Bizintek/mOway_Hardware/README.md

# mOway_Hardware
Project IR: PCB of the 4 obstacle sensors.

Project Moway: Main PCB of the mOway robot.
## License
This project is licensed under the Attribution-ShareAlike 4.0 International - see the LICENSE.md file for details
