Bizintek/mOway_Hardware/IR/Assembly/BOM/Bizintek - Bill of Materials-MIN_MOW_03 IR_V3.xlsx

 |  |  |  |  |  |  |  |  |  | Project | MIN_MOW_03 IR_V3.PrjPcb
 |  |  |  |  |  |  |  |  |  | Revision | V2
 |  |  |  |  |  |  |  |  |  | Date | 10/04/2018 11:36:07
 |  |  |  |  |  |  |  |  |  | Author | AVI
PCB COMPONENTS
Designator | Description | Comment | Value | Footprint | Manufacturer | Manufacturer Part Number | Quantity | Supplier 1 | Supplier Part Number 1 | Supplier 2 | Supplier Part Number 2
C1, C2, C3, C4 | CAPACITOR SMD 0603, 22nF , 10V, X7R | C22NV10X7R0603 | 22nF | C0603 |  |  | 4
C5 | CAPACITOR SMD 0603, 100nF, 10V, X7R | C100NV10X7R0603 | 100nF | C0603 |  |  | 1
EXT1 | PCB_MINMOW_V3_IR | PCB_MINMOW_V3_IR |  |  | BIZINTEK | PCB_MINMOW_V2_IR | 1
Q1, Q2, Q3, Q4 | SMT Phototransistor, 15º angle, 910nm, 3.45mA (SIDE MOUNTING) | PT100MF0MP | 35V/0.02A | PT100MF0MP_SIDE | SHARP | PT100MF0MP | 4 | Mouser | 852-PT100MF0MP | Digikey | 425-1006-1-ND
R1, R2, R11, R12 | RESISTOR SMD 0402, 39kOhm, 1% | R39KT10402 | 39kOhm | R0402 |  |  | 4
R3, R4, R5, R6, R15, R16, R17, R18 | RESISTOR SMD 0402, 4.7kOhm, 1% | R4K7T10402 | 4.7kOhm | R0402 |  |  | 8
R7, R9, R19, R21 | RESISTOR SMD 0402, 22kOhm, 1% | R22KT10402 | 22kOhm | R0402 |  |  | 4
R8, R10, R20, R22 | RESISTOR SMD 0402, 1kOhm, 1% | R1KT10402 | 1kOhm | R0402 |  |  | 4
R13, R14, R23, R24 | RESISTOR SMD 0402, 100Ohm, 1% | R100T10402 | 100Ohm | R0402 |  |  | 4
U1 | 1MHz Low-Power Op Amp | MCP6004IST |  | TSSOP14_MCP | MICROCHIP | MCP6004-I/ST | 1 | Digikey | MCP6004-I/ST-ND | Mouser | 579-MCP6004-I/ST
