Bizintek/mOway_Hardware/Moway/Assembly/BOM/Bizintek - Bill of Materials-MIN_MOW_03_V3.xlsx

 |  |  |  |  |  |  |  |  |  | Project | MIN_MOW_03_V3.PrjPcb
 |  |  |  |  |  |  |  |  |  | Revision | V2
 |  |  |  |  |  |  |  |  |  | Date | 10/04/2018 11:30:09
 |  |  |  |  |  |  |  |  |  | Author | AVI
PCB COMPONENTS
Designator | Description | Comment | Value | Footprint | Manufacturer | Manufacturer Part Number | Quantity | Supplier 1 | Supplier Part Number 1 | Supplier 2 | Supplier Part Number 2
C1, C2, C3, C4, C10, C15, C17, C22, C29 | CAPACITOR SMD 0402, 100nF, 10V, X7R | C100NV10X7R0402 | 100nF | C0402 |  |  | 9
C5, C14, C20, C27, C28 | CAPACITOR SMD 0603, 10uF, 10V, X5R | C10UV10X5R0603 | 10uF | C0603 |  |  | 5
C6, C7 | CAPACITOR SMD 0402, 18pF, 10V, C0G | C18PV10C0G0402 | 18pF | C0402 |  |  | 2
C8, C12, C16, C19, C21, C30, C31 | CAPACITOR SMD 0402, 1uF, 10V, X5R | C1UV10X5R0402 | 1uF | C0402 |  |  | 7
C9, C18, C25, C26 | CAPACITOR SMD 0402, 4.7uF, 10V, X5R | C4U7V10X5R0402 | 4.7uF | C0402 |  |  | 4
C11, C13 | CAPACITOR SMD 0603, 33pF, 10V, C0G | C33PV10C0G0603 | 33pF | C0603 |  |  | 2
C23, C24 | CAPACITOR SMD 0402, 1nF, 10V, X7R | C1NV10X7R0402 | 1nF | C0402 |  |  | 2
D1, D2 | IR-LED, SMD, 3mm x 2mm x 1 mm, 1,2V, 20mA, 940nm | KPA3010F3C |  | KPA3010 | KINGBRIGHT | KPA-3010F3C | 2 | Farnell | 2426200 | RS | 862-4705
D3 | IR-LED, SMD, 3mm x 2mm x 1 mm, 1,2V, 20mA, 940nm | DNP |  | KPA3010F3C_MOWAY | KINGBRIGHT | KPA-3010F3C | 1 | Farnell | 2426200 | RS | 862-4705
D4 | LED, Low Power, Green, SMD, 1.6mm x 2mm, 20mA, 2.2V, 568nm | KPC3216SGC |  | LED1206G | KINGBRIGHT | KPC-3216SGC | 1 | Farnell | 1318254 | RS | 466-3908
D5 | LED, Low Power, Red, SMD, 20 mA, 1.9 V, 628 nm | KP3216SURC |  | LED1206 | KINGBRIGHT | KP-3216SURC | 1 | Farnell | 8530017 | RS | 466-3920
D6 | LED Osram Opto, White, 4.5 lm, 5600K, 3.2 V, 120°, SIDELED serie | LWA6SGV2BAJKPL |  | LWA6SG | OSRAM | LW A6SG-V2BA-JKPL | 1 | Mouser | 720-LWA6SGV2BAJKPLZI | RS | 688-9578
D7, D8 | LED, Right Angle, Red, SMD, 20mA, 2V, 617nm | KPA3010EC |  | KPA3010 | KINGBRIGHT | KPA-3010EC | 2 | Farnell | 8530327 | RS | 862-4695
D9 | LED, Low Power, Red, SMD, 20 mA, 1.95 V, 630 nm | KPHCM2012SURCK |  | LED0805 | KINGBRIGHT | KPHCM-2012SURCK | 1 | Farnell | 1686067 | RS | 861-0119
D10 | LED, Low Power, Green, SMD, 20 mA, 2.1 V, 570 nm | KPHCM2012CGCK |  | LED0805 | KINGBRIGHT | KPHCM-2012CGCK | 1 | Farnell | 1686075 | RS | 861-0107
D11 | TVS Diode, SD05T1 Series, Unidirectional, 5 V, 14.5 V, SOD-323, 2 Pins | SD05T1G | 5V | SOD323_ONSEMI | ON SEMICONDUCTOR | SD05T1G | 1 | Farnell | 2463641 | Mouser | 863-SD05T1G
EXT1 | PCB_MINMOW_V3_MOWAY | PCB_MINMOW_V3_MOWAY |  |  | BIZINTEK |  | 1
EXT2, EXT4 | LIGHT PIPE | 5151049F |  | 5151049F | DIALIGHT | 5151049F | 2 | Digikey | 350-2175-ND | Mouser | 645-515-1049F
EXT3 | Light Pipe | PIPE44 |  | PIPE44_MR | MINIROBOTS | PIPE44 | 1
EXT5 | Li-Polymer Battery, 3.7V, 300mAh | LP602030 | 3.7V/0.30Ah |  | EEMB | LP602030 | 1
F1 | PPTC Resettable Fuse, SMD, MF-NSMF Series, 750 mA, 1.5 A, 6 V, -40 °C | MFNSMF0752 | 0.75A | F1206 | BOURNS | MF-NSMF075-2 | 1 | Digikey | MF-NSMF075-2CT-ND | Mouser | 652-MF-NSMF075-2
J1 | Ambient Light Photosensor, APDS-9005, Miniature, SMD, chipLED, Analogue, 1.8 V to 5.5 V | APDS9005020 |  | APDS9005020 | AVAGO | APDS-9005-020 | 1 | Mouser | 630-APDS-9005-020 | Digikey | 516-1717-1-ND
J3 | Board to Board connector, SMD, 6 pin, 1.27 pitch | 2215203G00DN3U |  | 22152X03_OUPIIN | OUPIIN | 2215-2X03G00DN-3U | 1 | MATRIX | 2215-2*03G00DN/3U
J4 | Expansion Connector, 8 pin, SMD Female | 20431X08TDATR |  | 20431X08TDATR_OUPIIN | OUPIIN | 2043-1X-08-T-D-A-TR | 1 | MATRIX | 2043-1X-08-T-D-A-TR
J6, J7, J8 | Wire-To-Board Connector, Top Entry, 1 mm, 2 Contacts, Header, SR Series, Surface Mount, 1 Rows | BM02BSRSSTB |  | BM02BSRSSTB_JST | JST | BM02B-SRSS-TB | 3 | Digikey | 455-1788-1-ND | Farnell | 1679127
L1, L2 | INDUCTOR SMD 120 Ohm / 100MHz, 2A, 0603 | BLM18PG121SN1D | 120 Ohm / 100MHz | L0603 | MURATA | BLM18PG121SN1D | 2 | Digikey | 490-1037-1-ND | Mouser | 81-BLM18PG121SN1D
MK1 | Electret Condenser Microphone | CMC5042PFAC |  | CMC5042PFAC | CUI | CMC-5042PF-AC | 1 | Digikey | 102-1724-ND | Mouser | 490-CMC-5042PF-AC
Q1, Q3, Q4, Q5, Q6, Q7, Q8, Q9, Q10, Q11, Q12, Q13, Q14 | Bipolar (BJT) Single Transistor, NPN, 45 V, 170 MHz, 300 mW, 500 mA, 250 hFE | BC81740MTF | 45V/0.5A | SOT23_FAIRCHILD | FAIRCHILD | BC81740MTF | 13 | Farnell | 1798081 | Mouser | 512-BC81740MTF
Q2 | Bipolar (BJT) Single Transistor, NPN, 45 V, 170 MHz, 300 mW, 500 mA, 250 hFE | DNP | 45V/0.5A | SOT23_FAIRCHILD | FAIRCHILD | BC81740MTF | 1 | Farnell | 1798081 | Mouser | 512-BC81740MTF
R1, R13, R14 | RESISTOR SMD 0402, 10Ohm, 1% | R10T10402 | 10Ohm | R0402 |  |  | 3
R2 | RESISTOR SMD 0402, 33kOhm, 1% | R33KT10402 | 33kOhm | R0402 |  |  | 1
R3, R21, R38, R50, R53 | RESISTOR SMD 0402, 560Ohm, 1% | R560T10402 | 560Ohm | R0402 |  |  | 5
R4 | RESISTOR SMD 0402, 10Ohm, 1% | DNP | 10Ohm | R0402 |  |  | 1
R5 | Thermistor, NTC, 10 kohm, NB12 Series, 3630 K, SMD, 0805 | NB12K00103KBB | 10kOhm | R0805 | AVX | NB12K00103KBB | 1 | Farnell | 1672287 | Mouser | 581-NB12K00103KBB
R6 | RESISTOR SMD 0402, 100Ohm, 1% | DNP | 100Ohm | R0402 |  |  | 1
R7, R46, R48, R49, R51, R77, R78, R79, R81, R83, R84 | RESISTOR SMD 0402, 10kOhm, 1% | R10KT10402 | 10kOhm | R0402 |  |  | 11
R8, R47, R52 | RESISTOR SMD 0402, 15kOhm, 1% | R15KT10402 | 15kOhm | R0402 |  |  | 3
R9, R15, R20, R86 | RESISTOR SMD 0402, 100Ohm, 1% | R100T10402 | 100Ohm | R0402 |  |  | 4
R10, R11, R12, R16, R17, R18, R24, R25, R28, R29, R30, R32, R33 | RESISTOR SMD 0402, 180Ohm, 1% | R180T10402 | 180Ohm | R0402 |  |  | 13
R19, R31, R75 | RESISTOR SMD 0402, 150Ohm, 1% | R150T10402 | 150Ohm | R0402 |  |  | 3
R22, R23, R42, R43, R45 | RESISTOR SMD 0402, 4.7kOhm, 1% | R4K7T10402 | 4.7kOhm | R0402 |  |  | 5
R26, R34 | RESISTOR SMD 0402, 12kOhm, 1% | R12KT10402 | 12kOhm | R0402 |  |  | 2
R27, R35, R41, R54, R55, R56, R57, R58, R59, R60, R61, R66, R67, R68, R69, R70, R71, R72, R73, R80, R82 | RESISTOR SMD 0402, 1kOhm, 1% | R1KT10402 | 1kOhm | R0402 |  |  | 21
R36, R37, R44, R85 | RESISTOR SMD 0402, 100kOhm, 1% | R100KT10402 | 100kOhm | R0402 |  |  | 4
R39 | RESISTOR SMD 0402, 220kOhm, 1% | R220KT10402 | 220kOhm | R0402 |  |  | 1
R40 | Varistor SMD | CG0603MLC05LE |  | V0603 | BOURNS | CG0603MLC-05LE | 1 | Digikey | CG0603MLC-05LECT-ND | Mouser | 652-CG0603MLC-05RE
R62, R63, R64, R65 | RESISTOR SMD 0402, 1MOhm, 1% | R1MT10402 | 1MOhm | R0402 |  |  | 4
R74 | RESISTOR SMD 0402, 3.3kOhm, 1% | R3K3T10402 | 3.3kOhm | R0402 |  |  | 1
R76 | RESISTOR SMD 0402, 470Ohm, 1% | R470T10402 | 470Ohm | R0402 |  |  | 1
SW1 | Slide Switch, DPDT, On-On, SMD, 300 mA | MMS228T |  | MMS228T | KNITTER | MMS 228-T | 1 | Farnell | 8546819 | RS | 711-8329
U1 | 80-pin 1-Mbit FLASH USB MCU | PIC18F87J50TIPT |  | TQFP80_MCP | MICROCHIP | PIC18F87J50T-I/PT | 1 | Digikey | PIC18F87J50-I/PT-ND | Mouser | 579-PIC18F87J50-I/PT
U2, U3 |  | CNY70 |  |  |  |  | 2
U5 | PIEZO BUZZER TRANSDUCER, 73dB a 5V 10cm | CMT1102SMT |  | CMT1102SMT | CUI | CMT-1102-SMT | 1 | Digikey | 102-1264-1-ND | Mouser | 490-CMT-1102-SMT-TR
U6 | 1MHz Low-Power Op Amp | MCP6001RTEOT |  | SOT23-5_MCP | MICROCHIP | MCP6001RT-E/OT | 1 | Digikey | MCP6001RT-E/OTCT-ND | Mouser | 579-MCP6001RT-E/OT
U7 | MEMS Accelerometer, 3-Axis, Digital, X, Y, Z, ± 2g, ± 4g, ± 8g, 1.95 V, 3.6 V, QFN | MMA8452Q |  | QFN16-5x3_NXP | NXP | MMA8452Q | 1 | Mouser | 841-MMA8452Q | Farnell | 1842360
U8 | USB Connector, Mini USB Type B, 5 Ways, SMD | 8969B05C00DBT |  | 8969B05C00DBT_OUPIIN | OUPIIN | 8969-B05C00DBT | 1 | MATRIX | 8969-B05C00DBT
U9 | TVS Diode, RailClamp Series, 5 V, 18 V, SOT-666, 6 Pins | RCLAMP0502A | 5V | SOT666_SEMTECH | SEMTECH | RCLAMP0502A | 1 | Digikey | RCLAMP0502ACT-ND | Mouser | 947-RCLAMP0502A.TCT
U10, U12 | High Sensitivity Photointerrupter | KRC011 |  | KRC011 | KINGBRIGHT | KRC011 | 2 | RS | 616-5709
U11 | 20 PIN FLASH 8-Bit CMOS MCU | PIC16F687TISS |  | SSOP20_MCP | MICROCHIP | PIC16F687T-I/SS | 1 | Digikey | PIC16F687T-I/SSCT-ND | Mouser | 579-PIC16F687T-I/SS
U13, U14, U15, U16, U19 | Dual MOSFET, N and P Channel, 460 mA, 25 V, 0.33 ohm, 4.5 V, 800 mV | FDC6321CD84Z | N:25V/0.68A; P:25V/0.46A | SUPERSOT6_ONSEMI | FAIRCHILD | FDC6321C D84Z | 5 | Farnell | 9844848 | Mouser | 512-FDC6321C
U17 | Battery Charger for 1 Cell of Li-Ion, Li-Pol battery, 6V input, 4.2V / 500mA charge | MCP73831T2DCIOT | 4.2V/0.5A | SOT23-5_MCP | MICROCHIP | MCP73831T-2DCI/OT | 1 | Digikey | MCP73831T-2DCI/OTCT-ND | Mouser | 579-MCP73831T-2DCIOT
U18 | 500mA Fixed Output CMOS LDO. 6V Vin, 3.3 Vout, 0.5Aout | TC126233VDB | 3.3V/0.5A | SOT223_MCP | MICROCHIP | TC1262-3.3VDB | 1 | Digikey | TC1262-3.3VDB-ND | Mouser | 579-TC1262-3.3VDB
Y11 | Crystal, 12MHz, SMD, 5mm x 3.2mm, 8pF, 50ppm | NX5032GA12MHZLNCD1 | 12MHz | NX5032GA_NDK | NDK | NX5032GA-12.000000MHZ-LN-CD-1 | 1 | Digikey | 644-1034-1-ND
