Bizintek/mOway_Hardware/IR/ExportSTEP/MIN_MOW_03 IR_V3 PCB.step

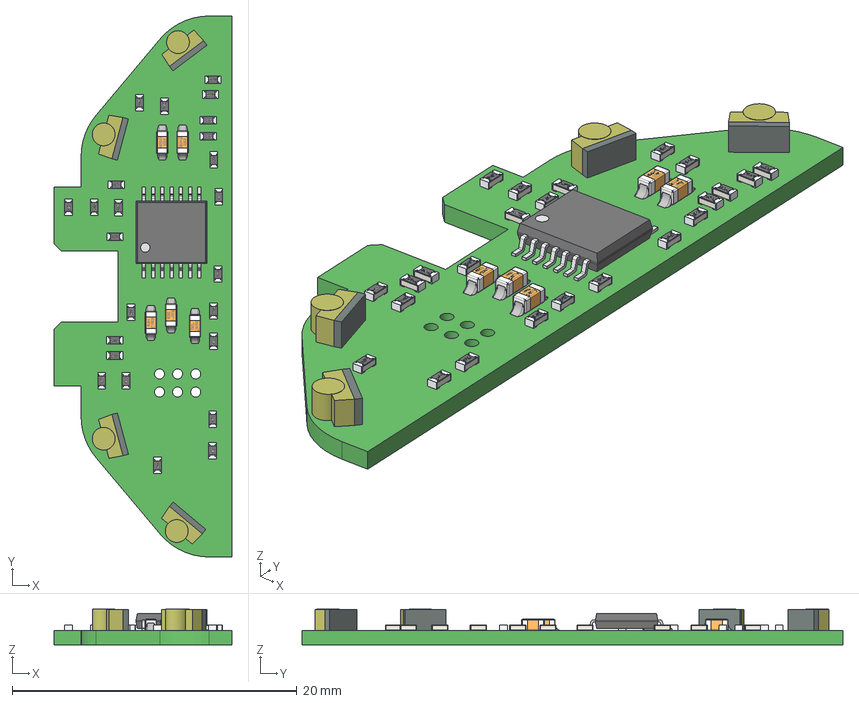
[picture p4: CAD file, 2018-06-08]
IR/ExportSTEP/MIN_MOW_03 IR_V3 PCB.step
12.5 x 38.0 x 2.51 mm
Board
User_Library-0603_Cap x 5
Extruded x 8
User_Library-RES_1005-0402 x 24
User_Library-TSSOP-14__X2_041A043E0440043F04430441_X0_
User_Library-TSSOP-14__X2_041C04350442043A0430_X0_
User_Library-TSSOP-14__X2_041D043E0436043A0430_X0_ x 7
