Bizintek/mOway_Hardware/IR/Design (CONF)/Schematic Prints.PDF

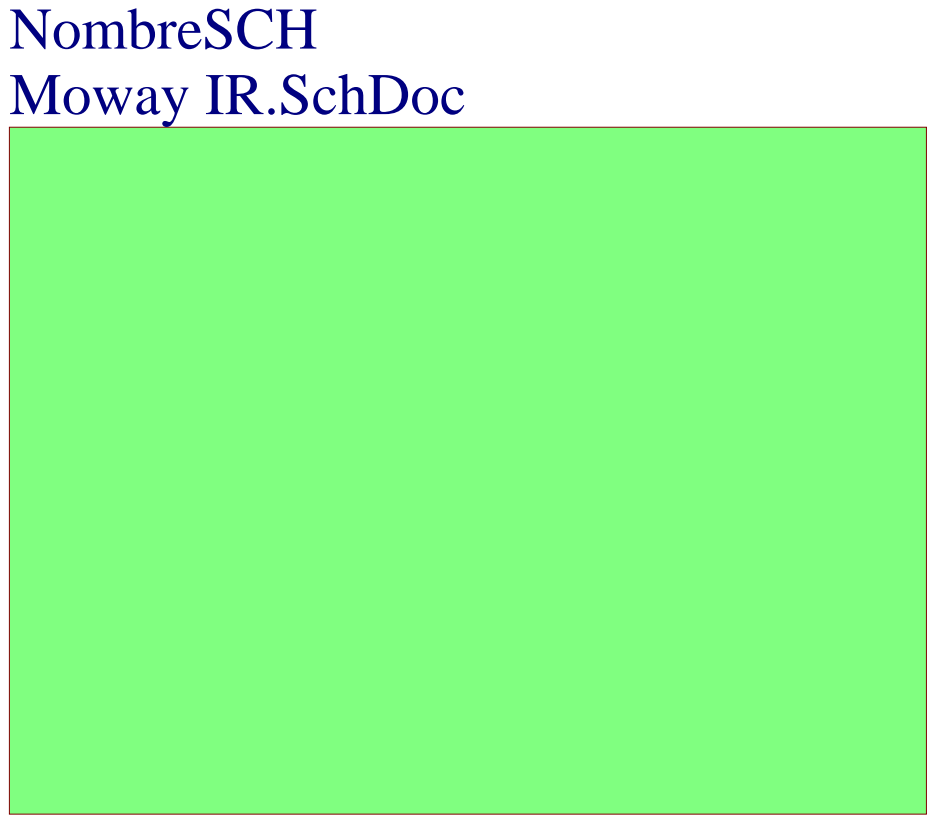
[picture p11: page 1]

Revision: V2 | 10/04/2018 | Sheet: 1 of 2
Author: AVI | Library Version: 2

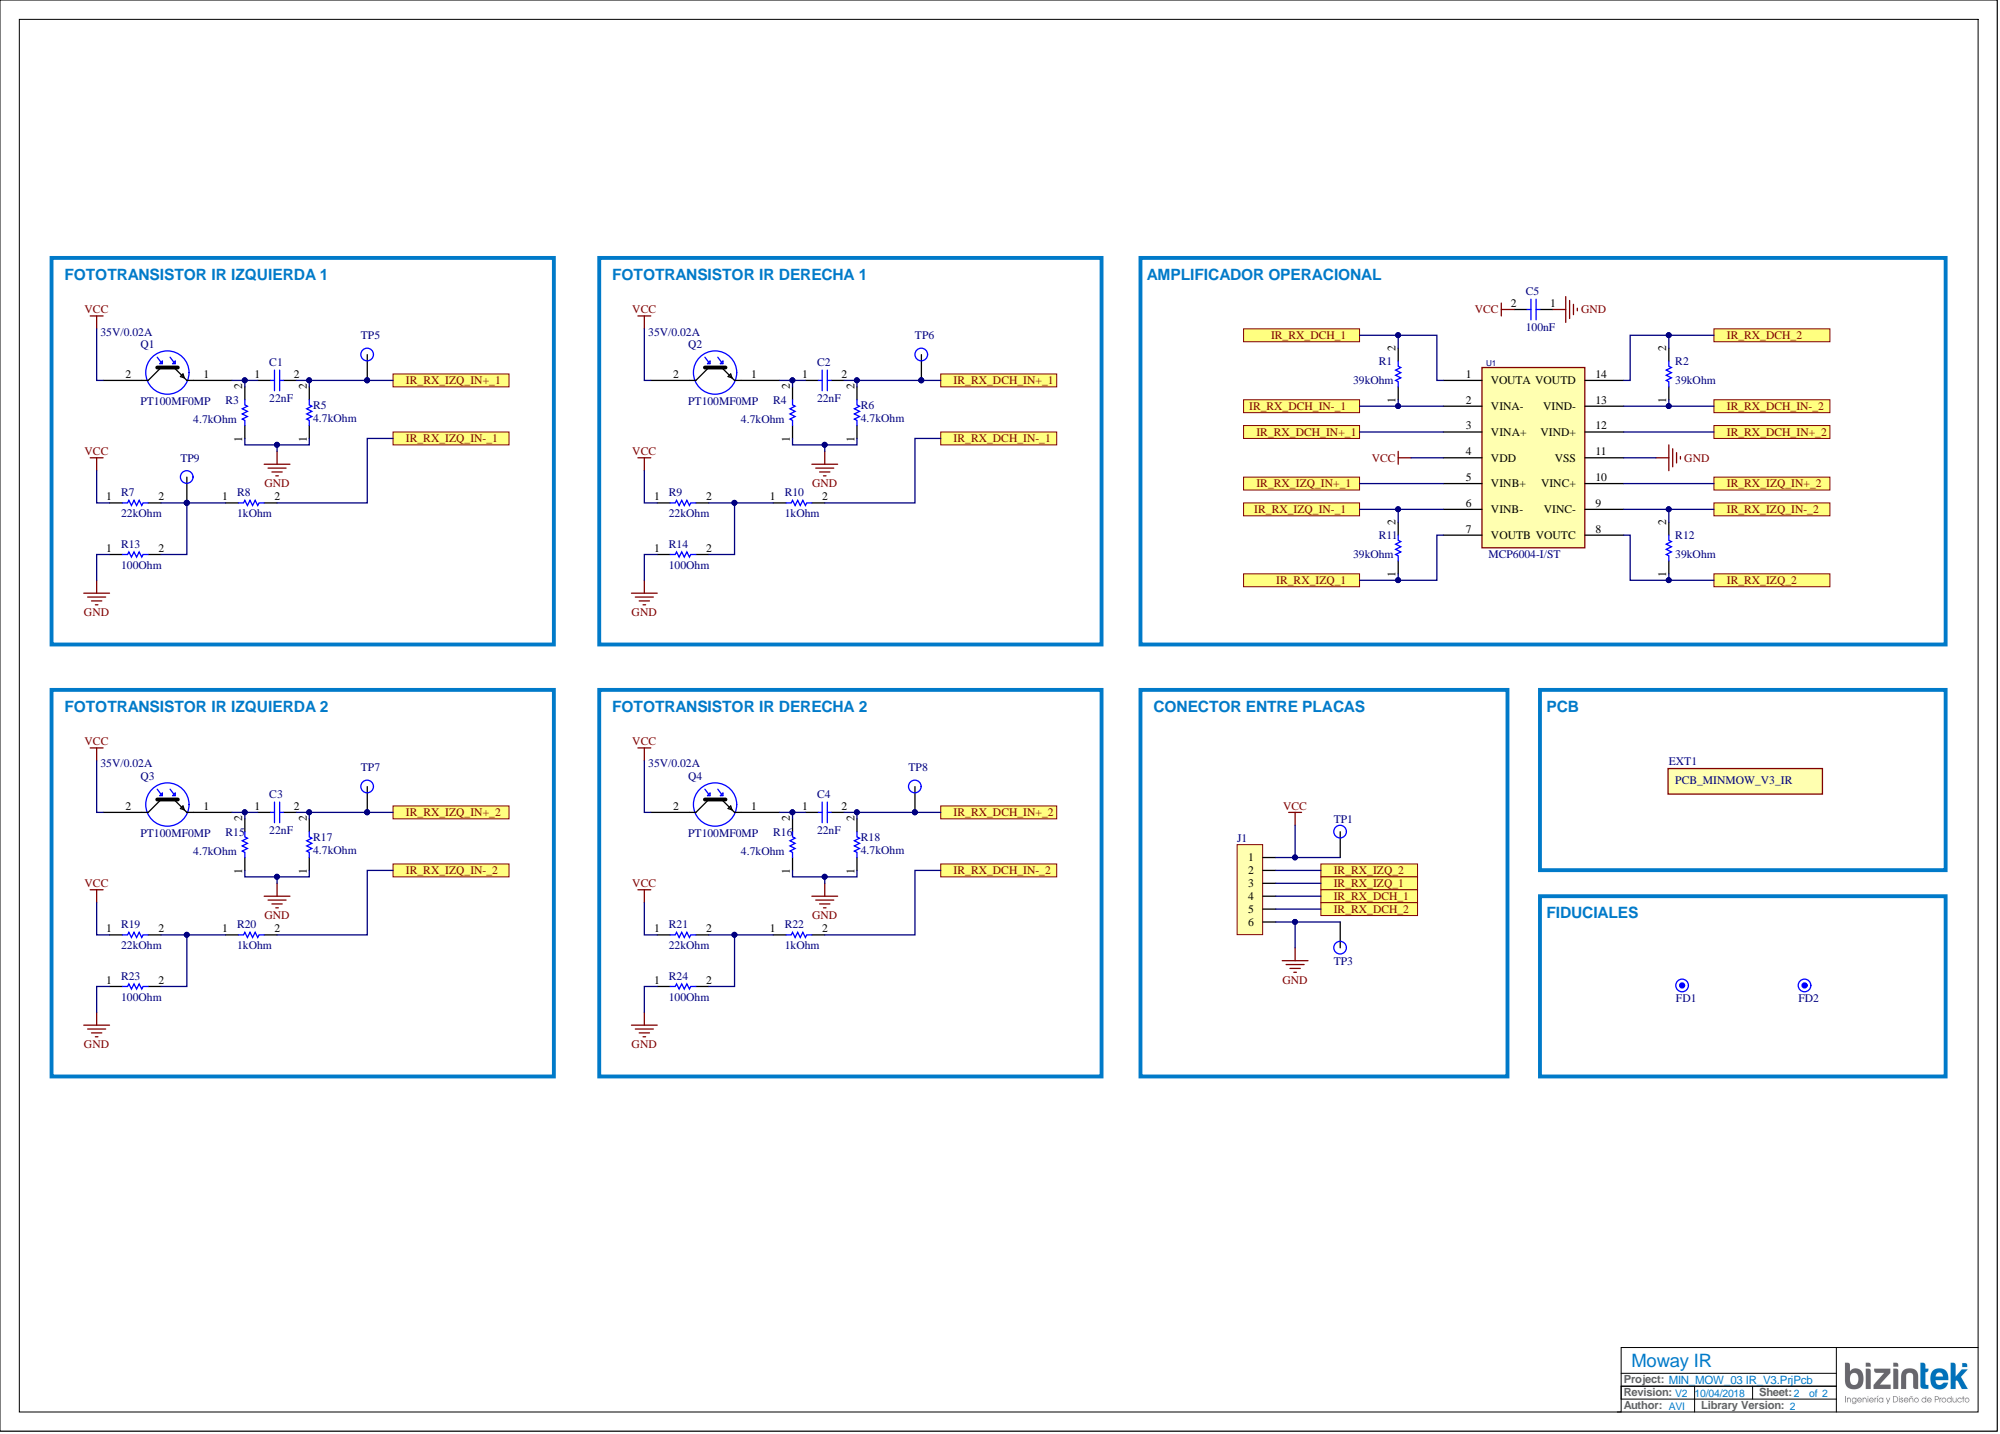
[picture p12: page 2]

Revision: V2 | 10/04/2018 | Sheet: 2 of 2
Author: AVI | Library Version: 2
