Bizintek/mOway_Hardware/Moway/Design (CONF)/PCB Prints.PDF

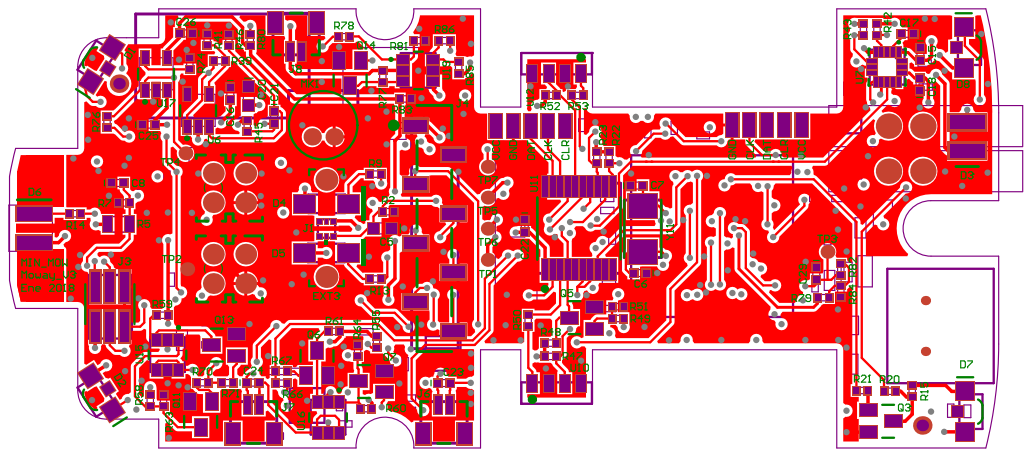
[picture p19: page 1]

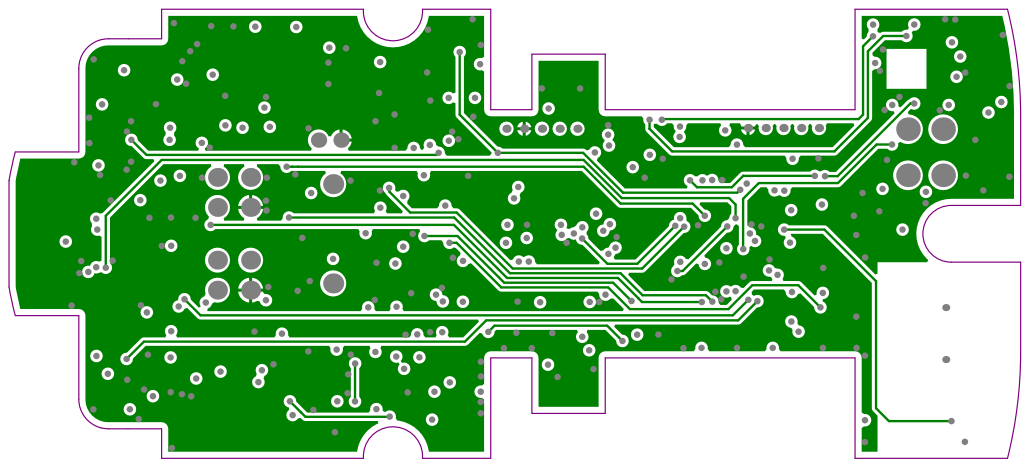
[picture p20: page 2]

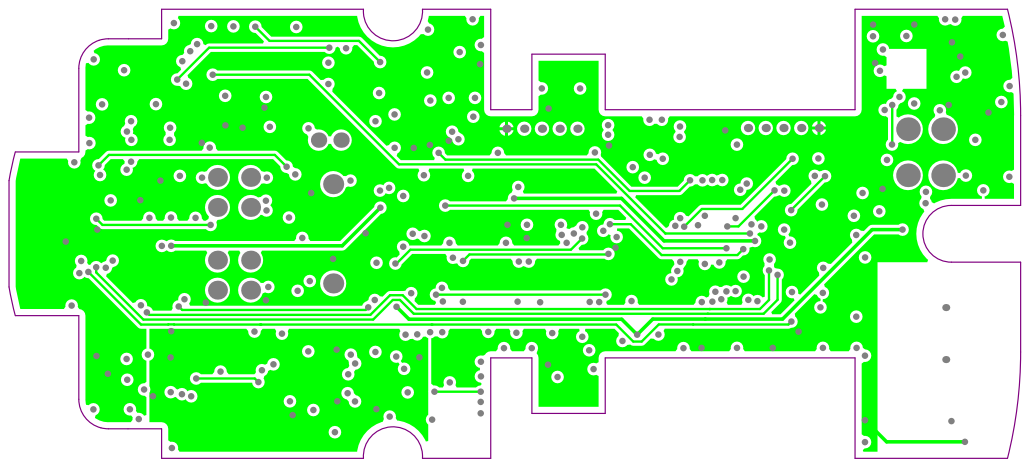
[picture p21: page 3]

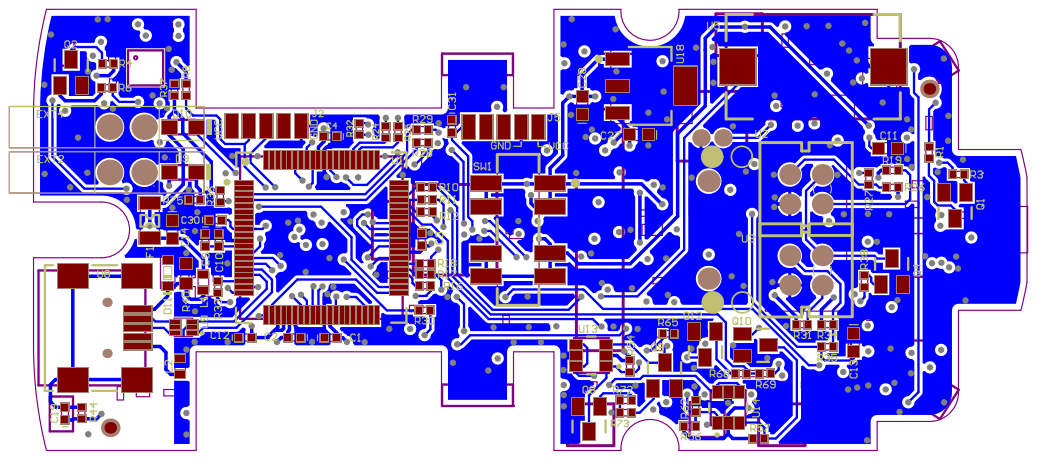
[picture p22: page 4]

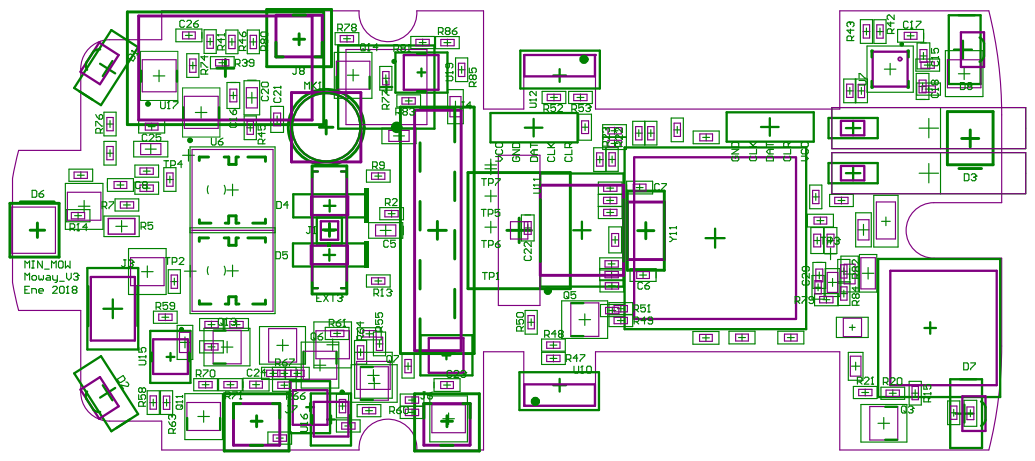
[picture p23: page 5]

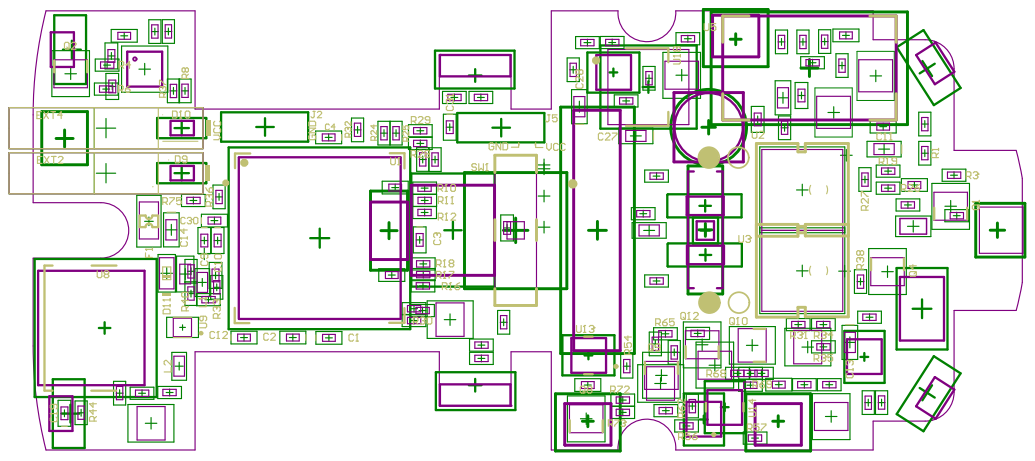
[picture p24: page 6]
