Bizintek/mOway_Hardware/Moway/Design (CONF)/Schematic Prints.PDF

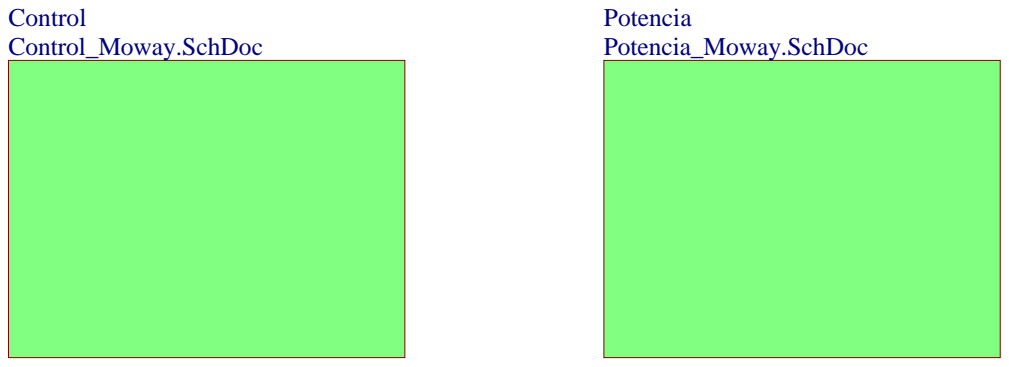
[picture p25: page 1]

Revision: V2 | 10/04/2018 | Sheet: 1 of 3
Author: AVI | Library Version: 2

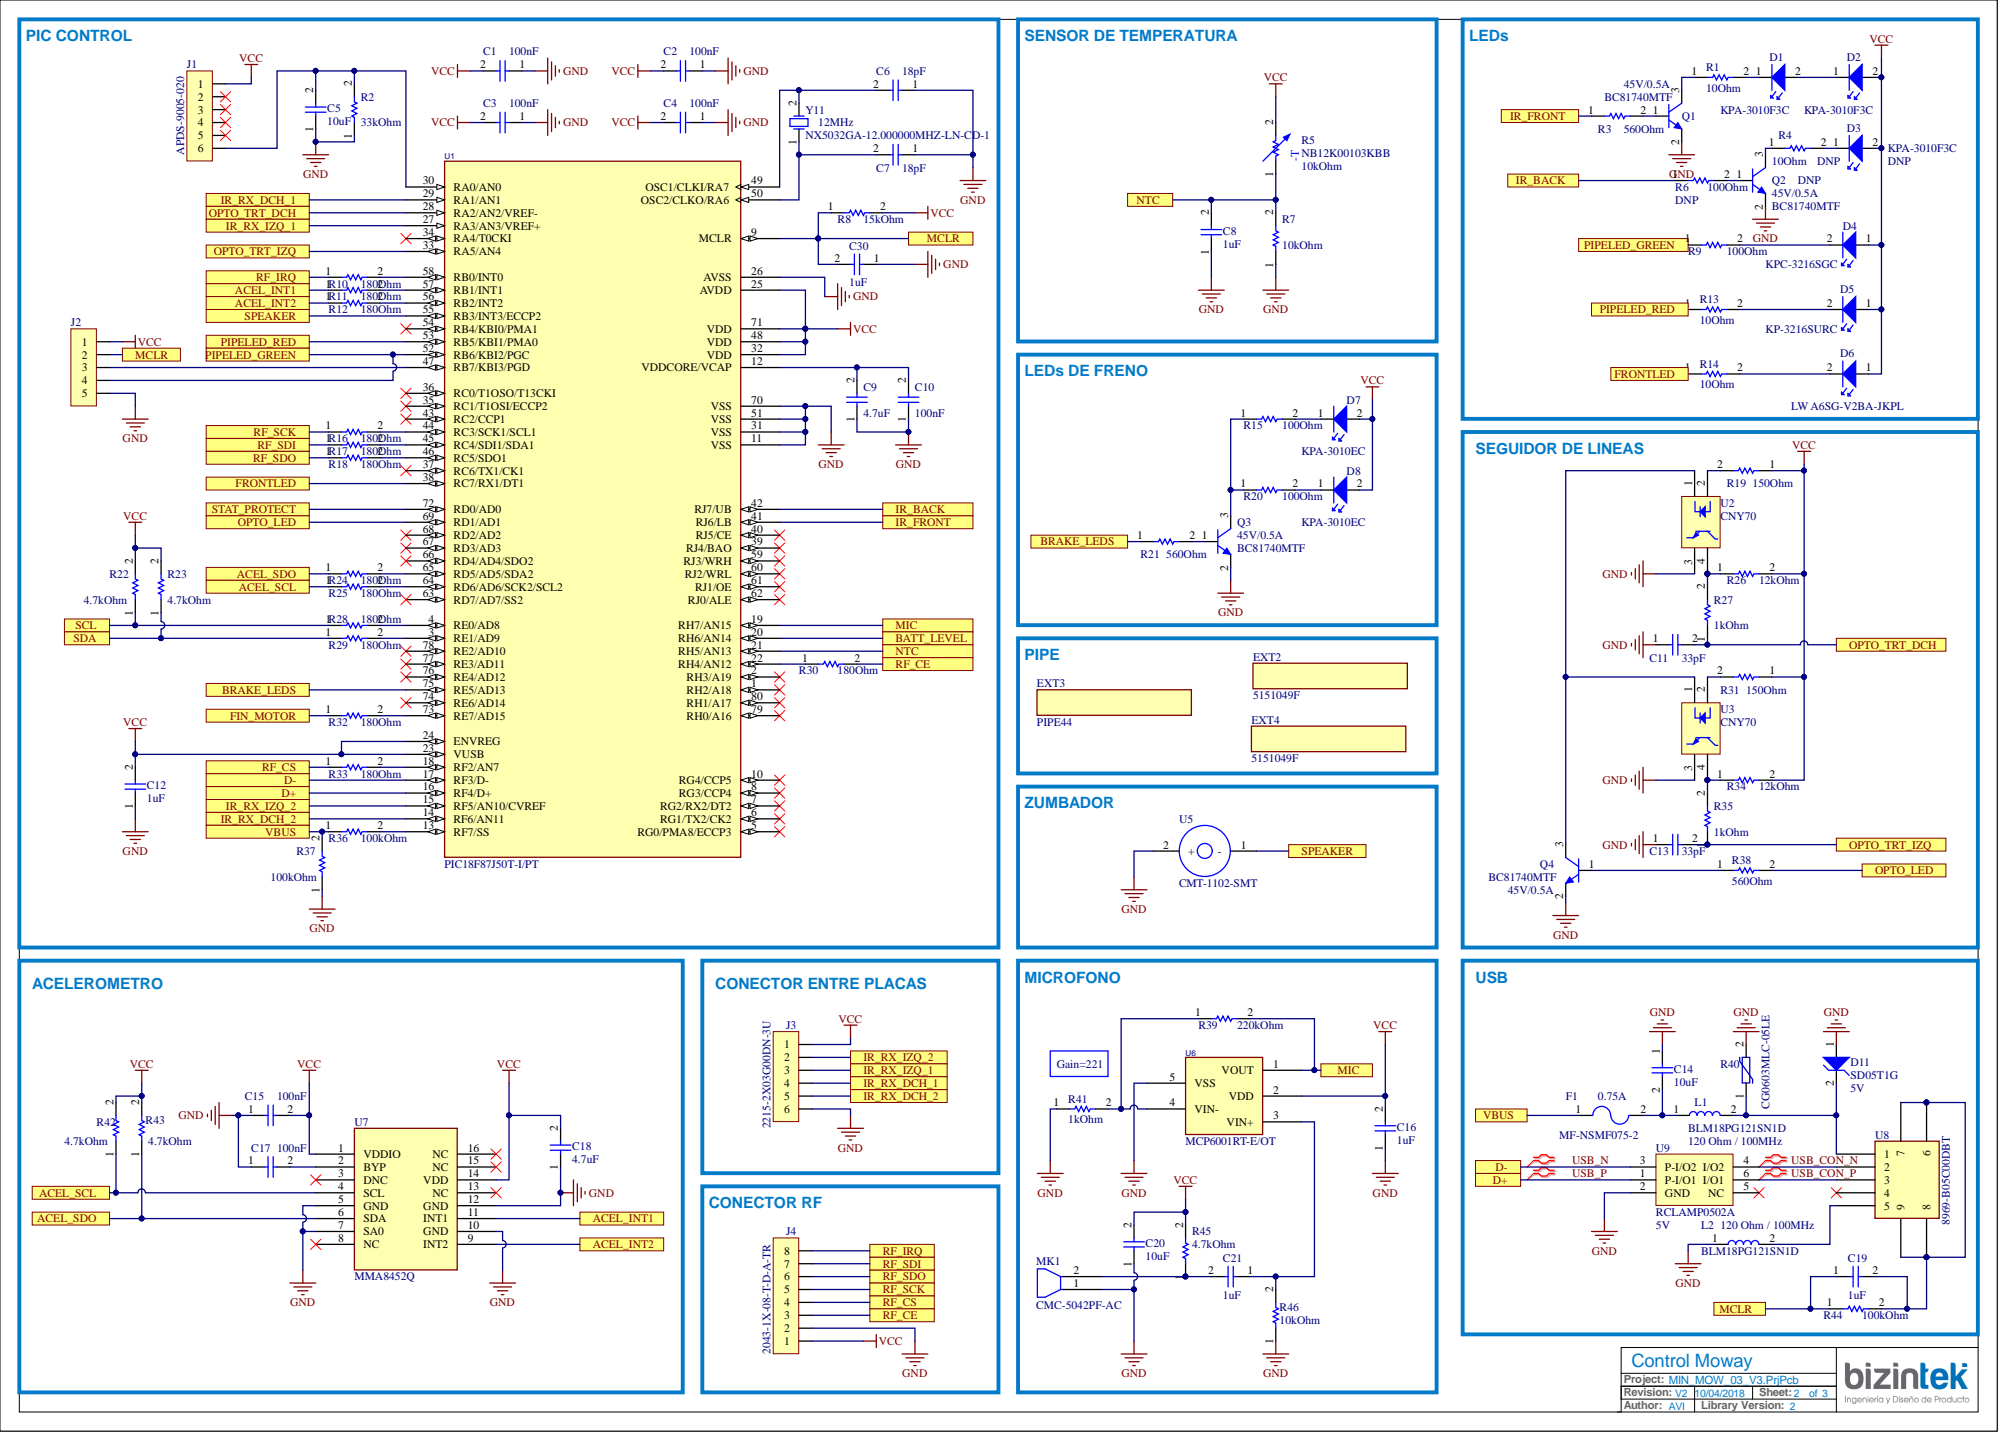
[picture p26: page 2]

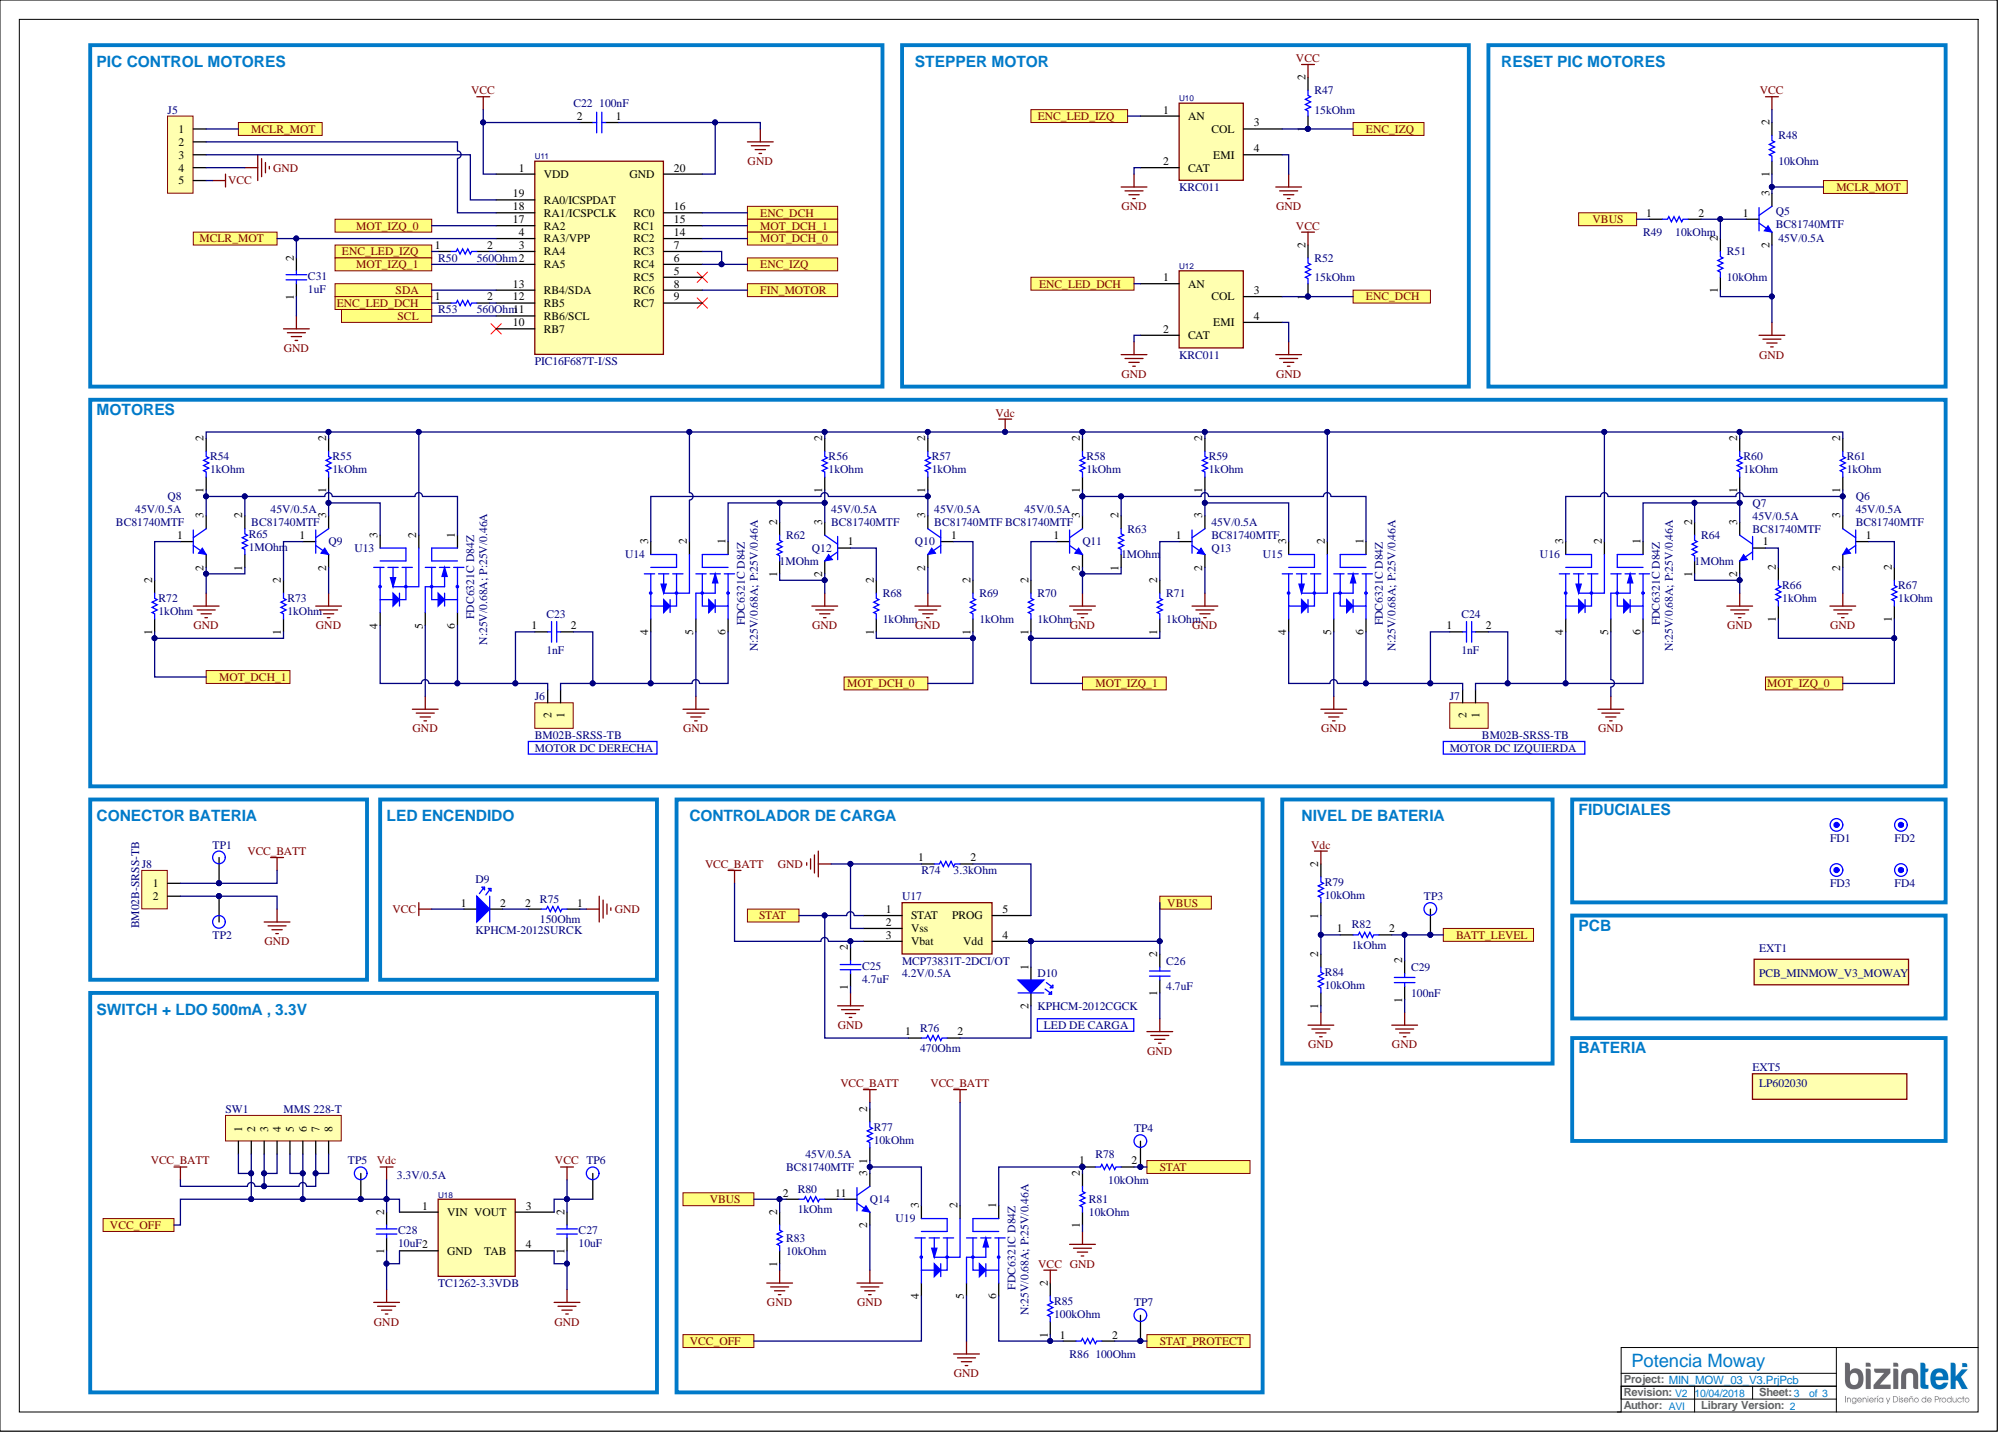
[picture p27: page 3]
