Bizintek/mOway_Hardware/Moway/Assembly/PCB Print/Assembly Drawings of Panel.PDF

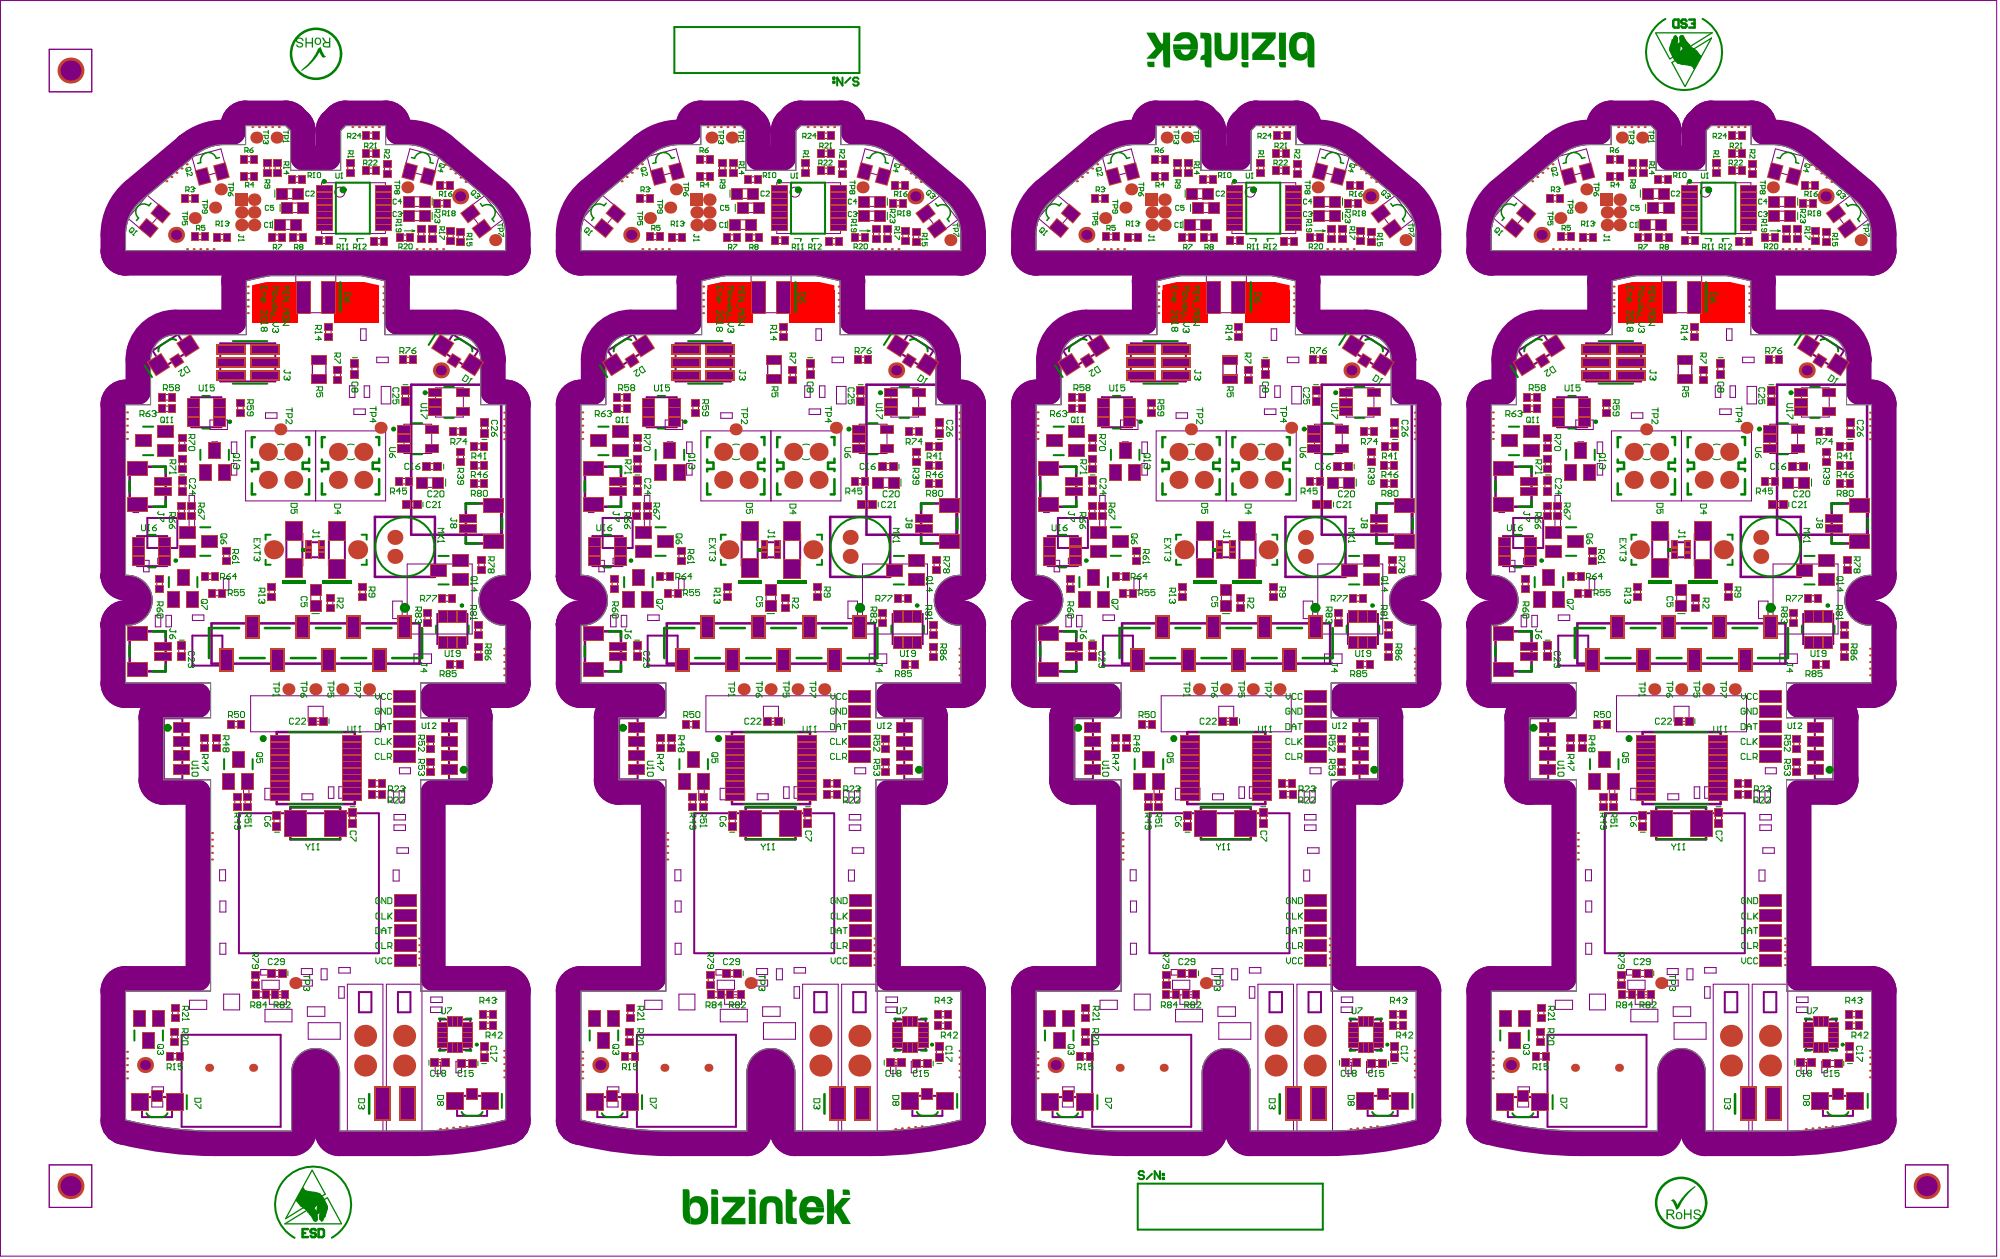
[picture p32: page 1]

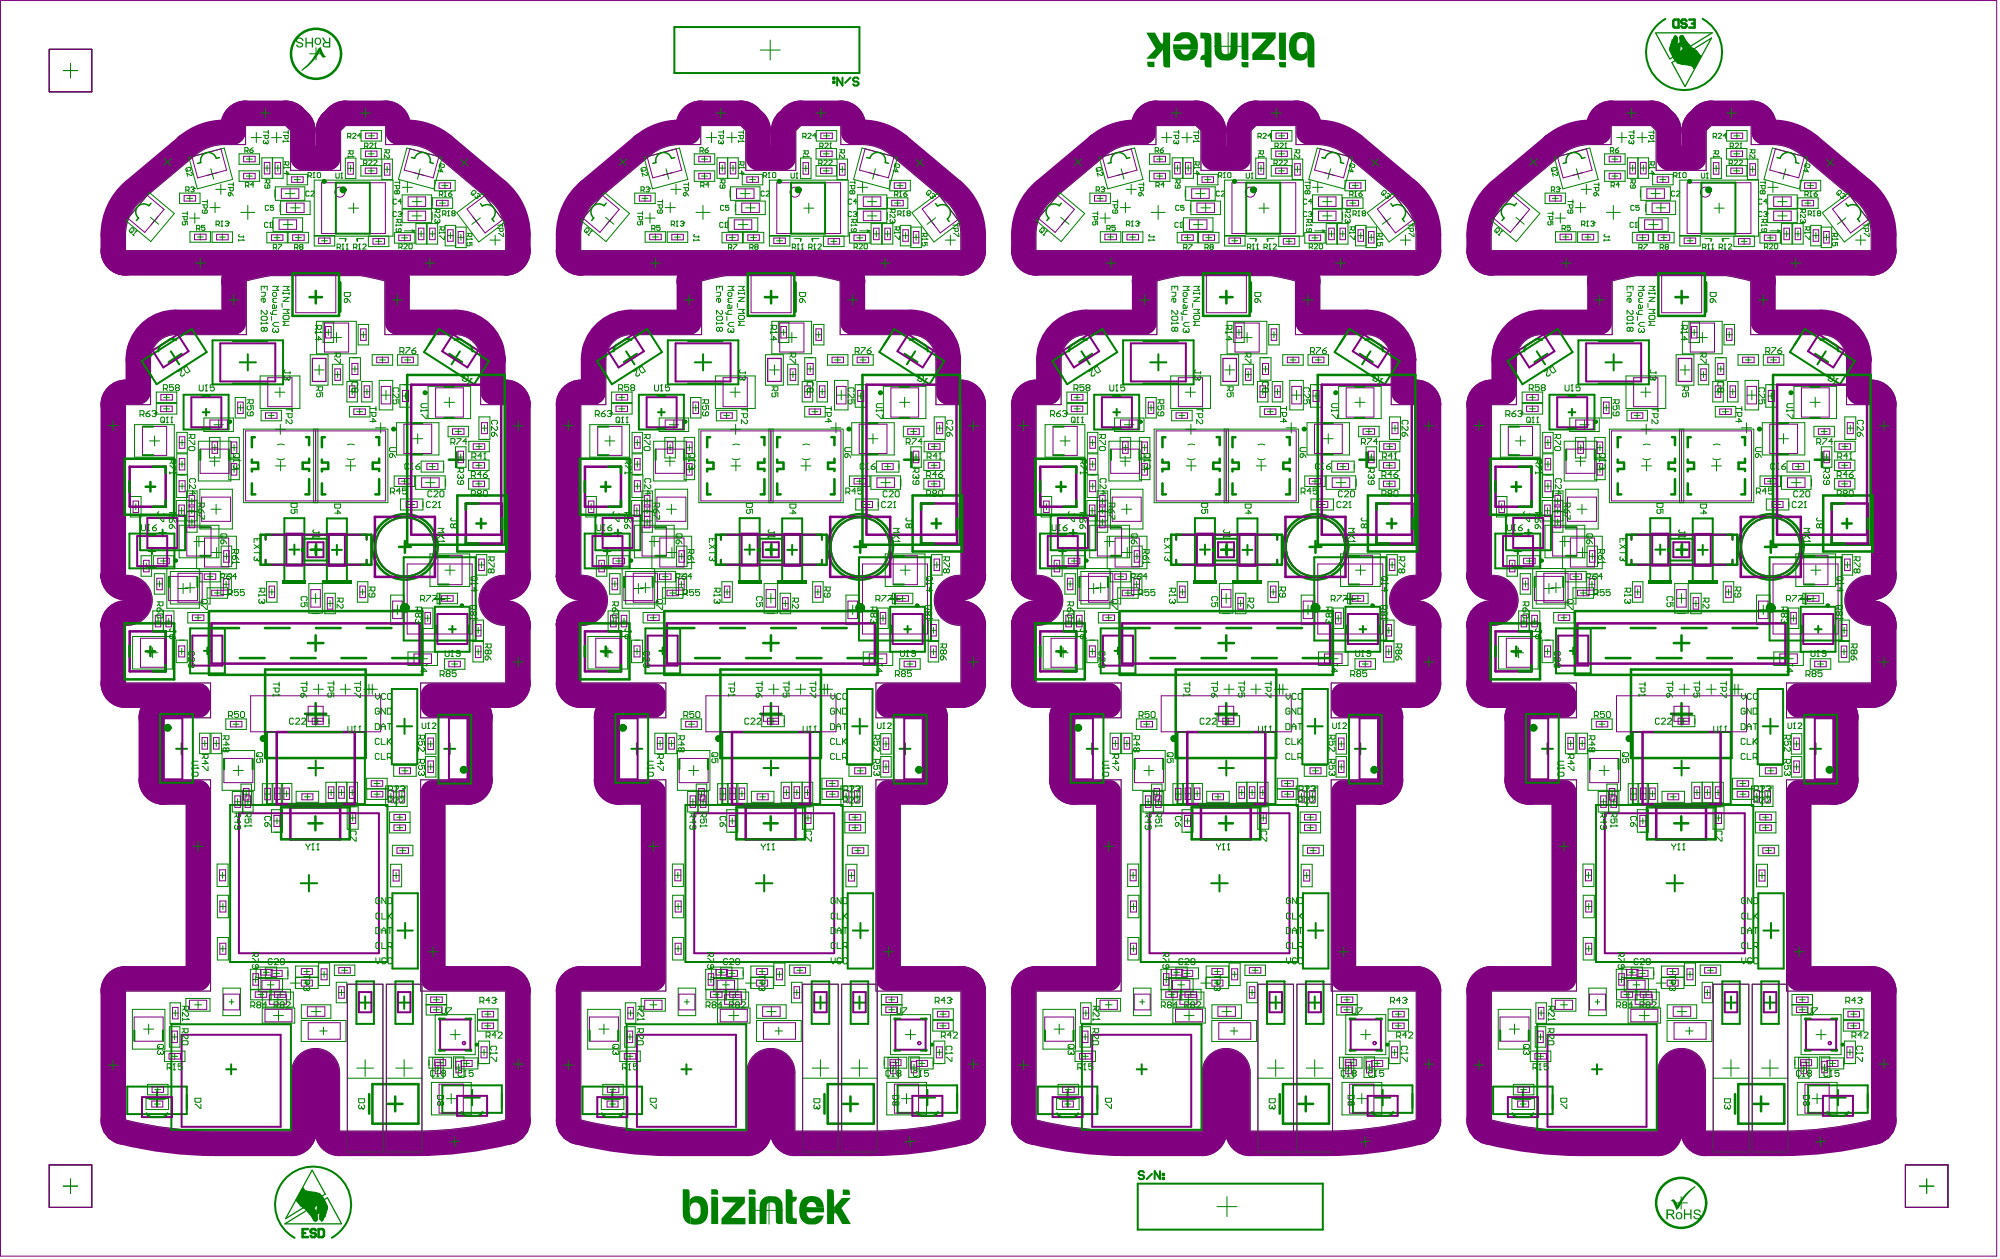
[picture p33: page 2]

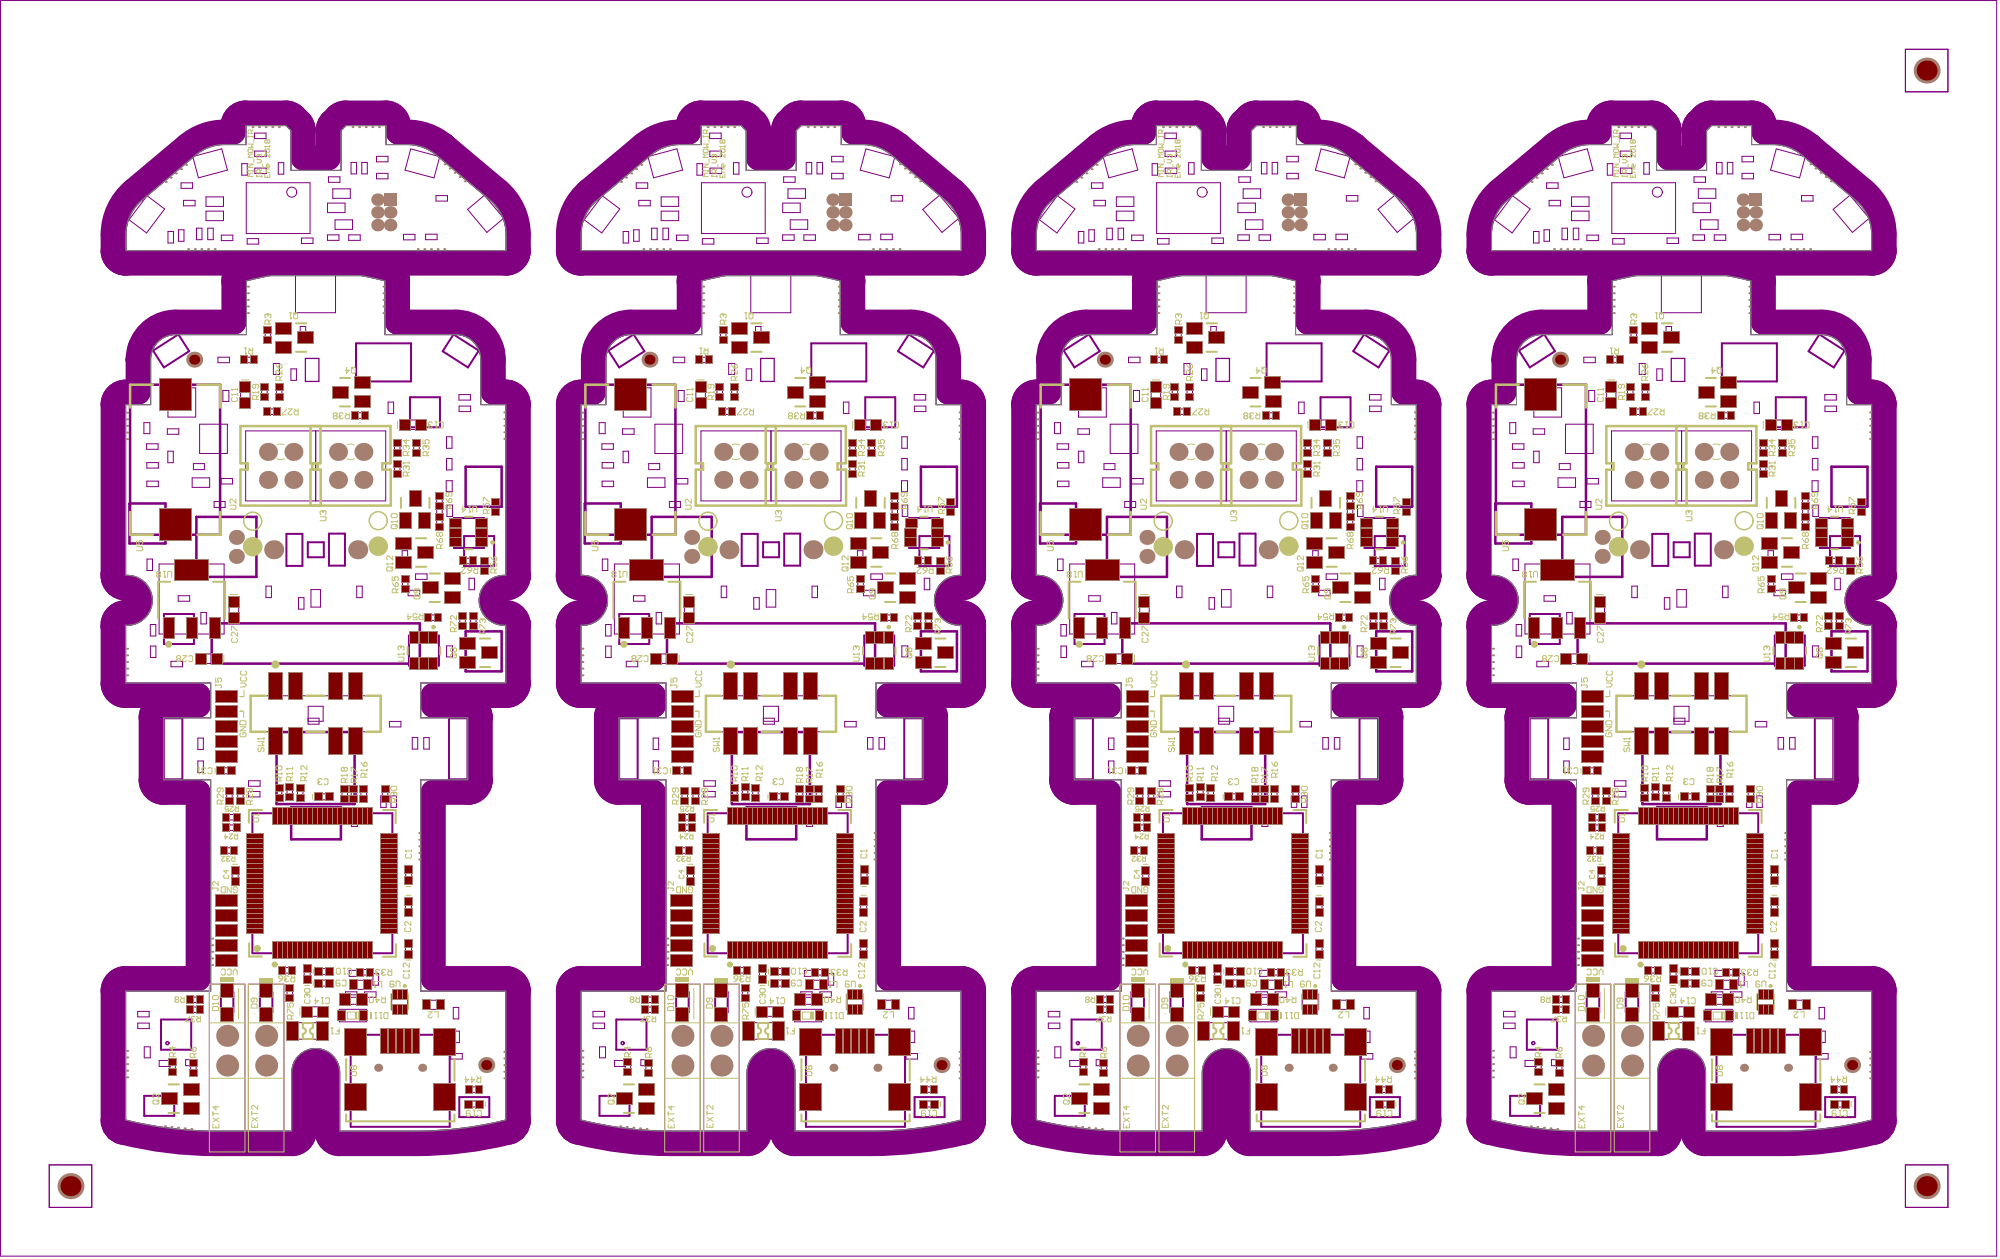
[picture p34: page 3]

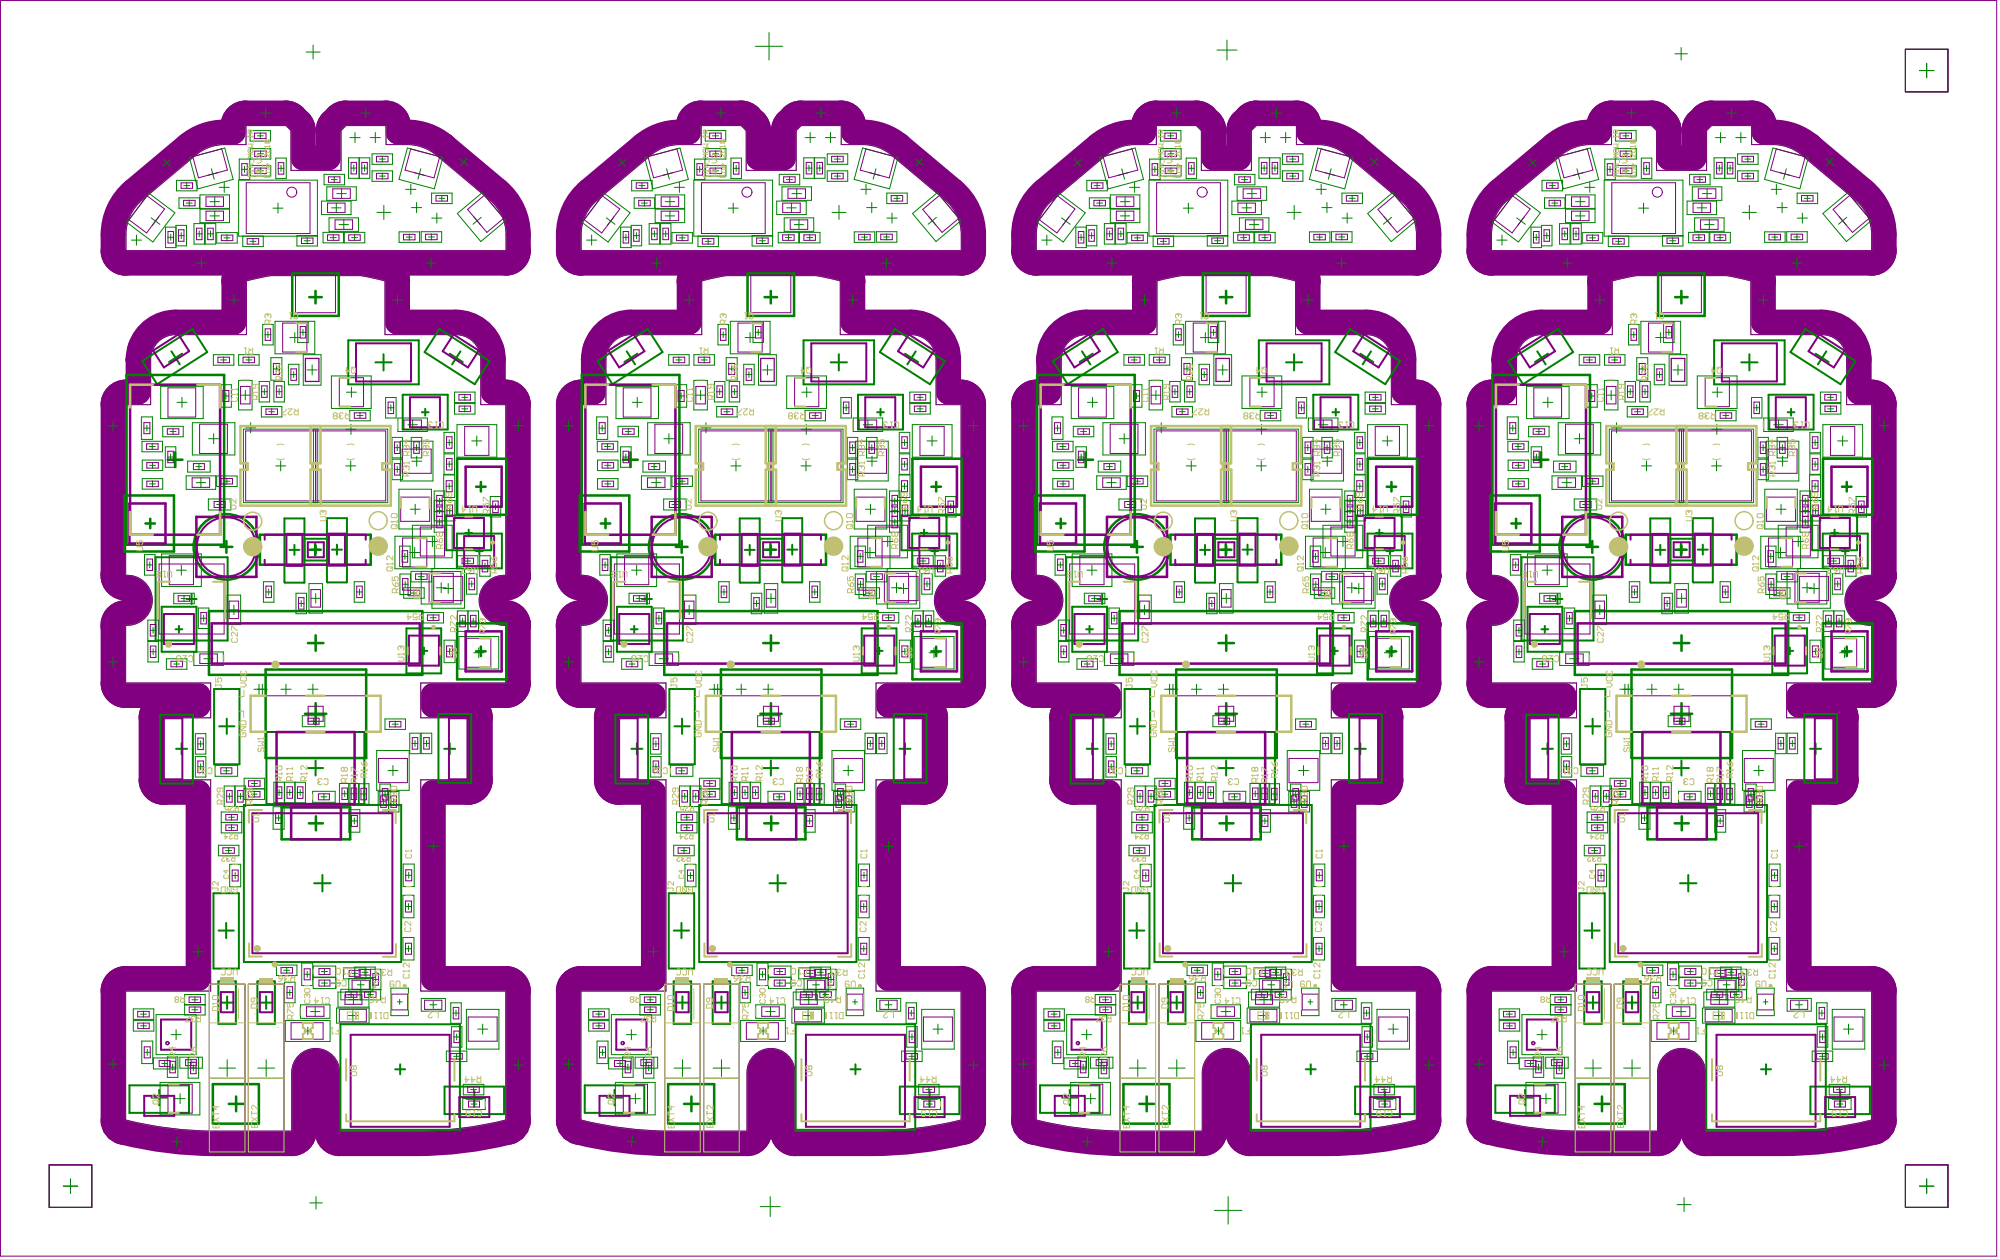
[picture p35: page 4]
