Bizintek/mOway_Hardware/(list of files, drawings)

Other design files:
IR/Design (CONF)/Altium/Block Diagram.SchDoc
IR/Design (CONF)/Altium/MIN_MOW_03 IR_V3 PCB.PcbDoc
IR/Design (CONF)/Altium/MIN_MOW_03 IR_V3.PrjPcb
IR/Design (CONF)/Altium/Moway IR.SchDoc
Moway/Design (CONF)/Altium/Block Diagram.SchDoc
Moway/Design (CONF)/Altium/Control_Moway.SchDoc
Moway/Design (CONF)/Altium/MIN_MOW_03_V3.PrjPcb
Moway/Design (CONF)/Altium/MIN_MOW_Moway_V3 Panel.PcbDoc
Moway/Design (CONF)/Altium/Potencia_Moway.SchDoc
